RuchchaSD/Portenta_h7_breakout/README.md

# Portenta_h7_breakout
This  library contains the design files and design procedure of the breakout board portenta playmate
