RuchchaSD/Portenta_h7_breakout/lasercut parts/Bottom.DXF

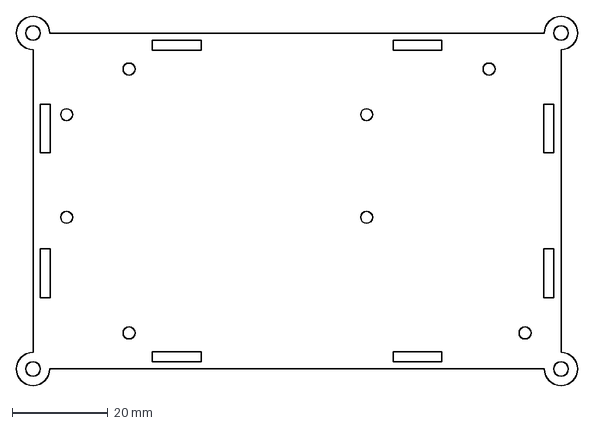
[picture p25: CAD file, 2023-09-10]
lasercut parts/Bottom.DXF
117.0 x 77.0 mm
