RuchchaSD/Portenta_h7_breakout/lasercut parts/front.DXF

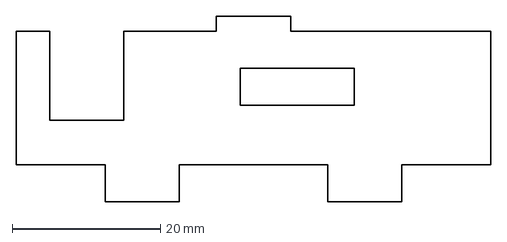
[picture p26: CAD file, 2023-09-10]
lasercut parts/front.DXF
64.0 x 25.0 mm
