RuchchaSD/Portenta_h7_breakout/lasercut parts/right.DXF

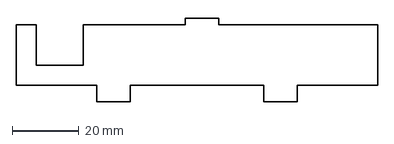
[picture p27: CAD file, 2023-09-10]
lasercut parts/right.DXF
108.0 x 25.0 mm
