RuchchaSD/Portenta_h7_breakout/lasercut parts/rear.DXF

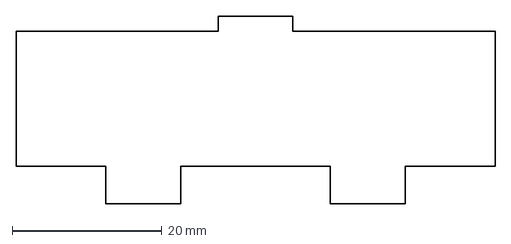
[picture p28: CAD file, 2023-09-10]
lasercut parts/rear.DXF
64.0 x 25.0 mm
