RuchchaSD/Portenta_h7_breakout/lasercut parts/Top.DXF

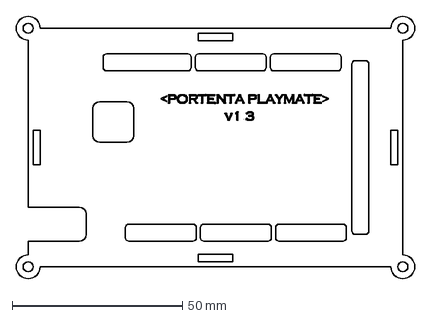
[picture p29: CAD file, 2023-09-10]
lasercut parts/Top.DXF
117.0 x 77.0 mm
