RuchchaSD/Portenta_h7_breakout/lasercut parts/left.DXF

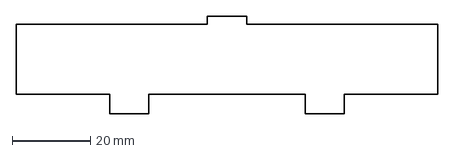
[picture p30: CAD file, 2023-09-10]
lasercut parts/left.DXF
108.0 x 25.0 mm
