RuchchaSD/Portenta_h7_breakout/Portanta Playmate schematic.pdf

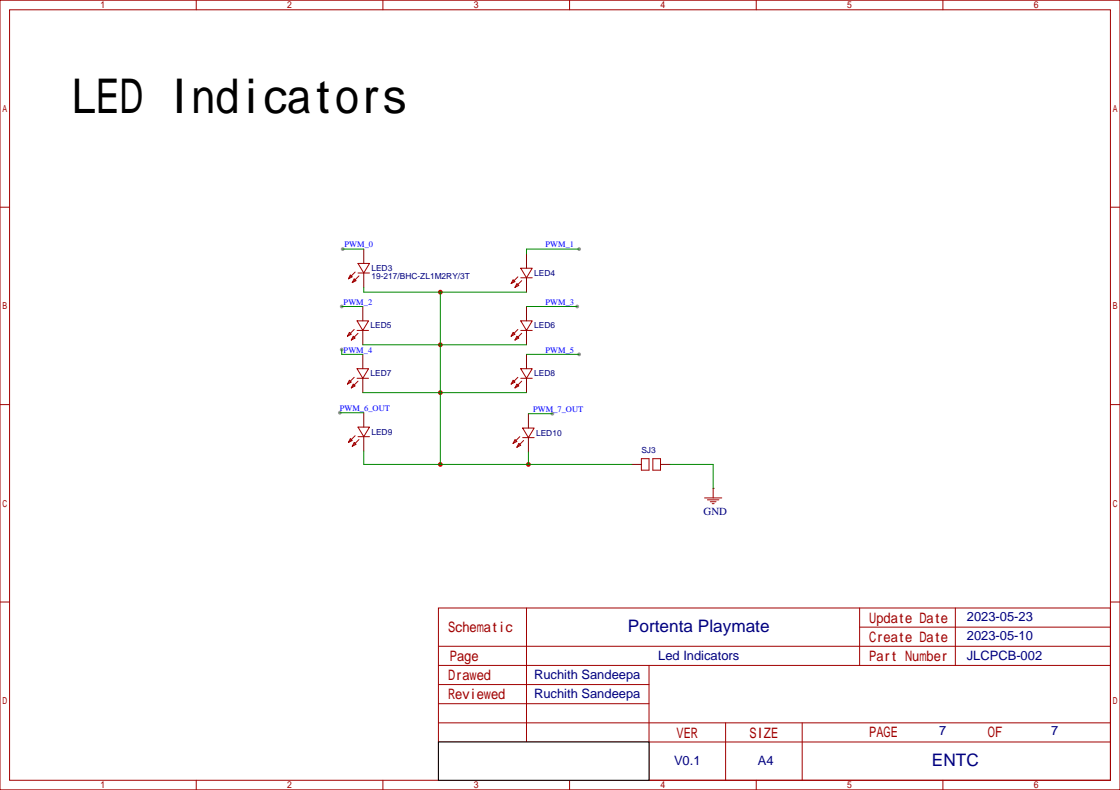
[picture p37: page 7]
