RuchchaSD/Portenta_h7_breakout/Portanta Playmate schematic.pdf

+5V

# Header Connections

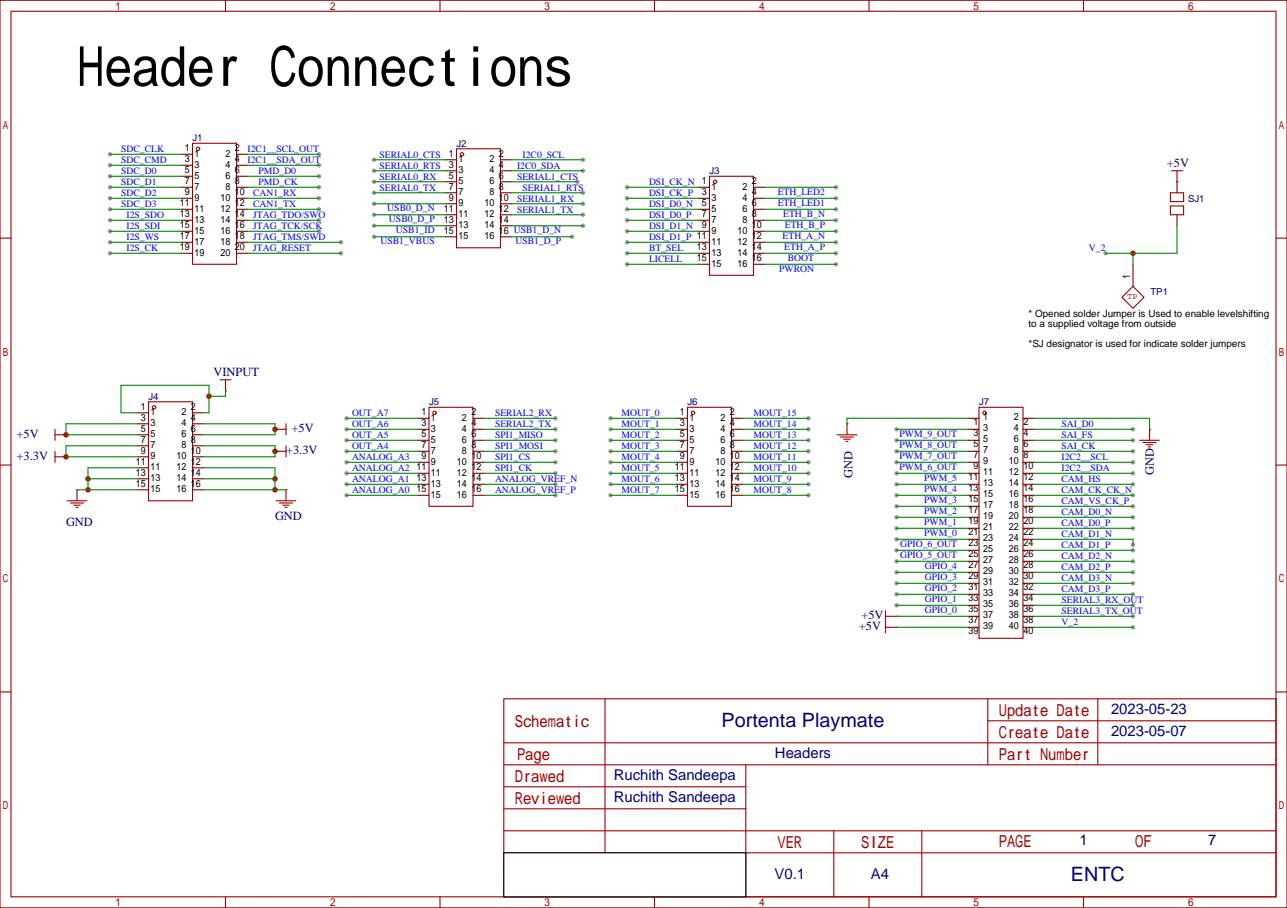
[picture p31: page 1]

* Opened solder Jumper is Used to enable levelshifting
to a supplied voltage from outside
*SJ designator is used for indicate solder jumpers

+5V

# Analog Multiplexer

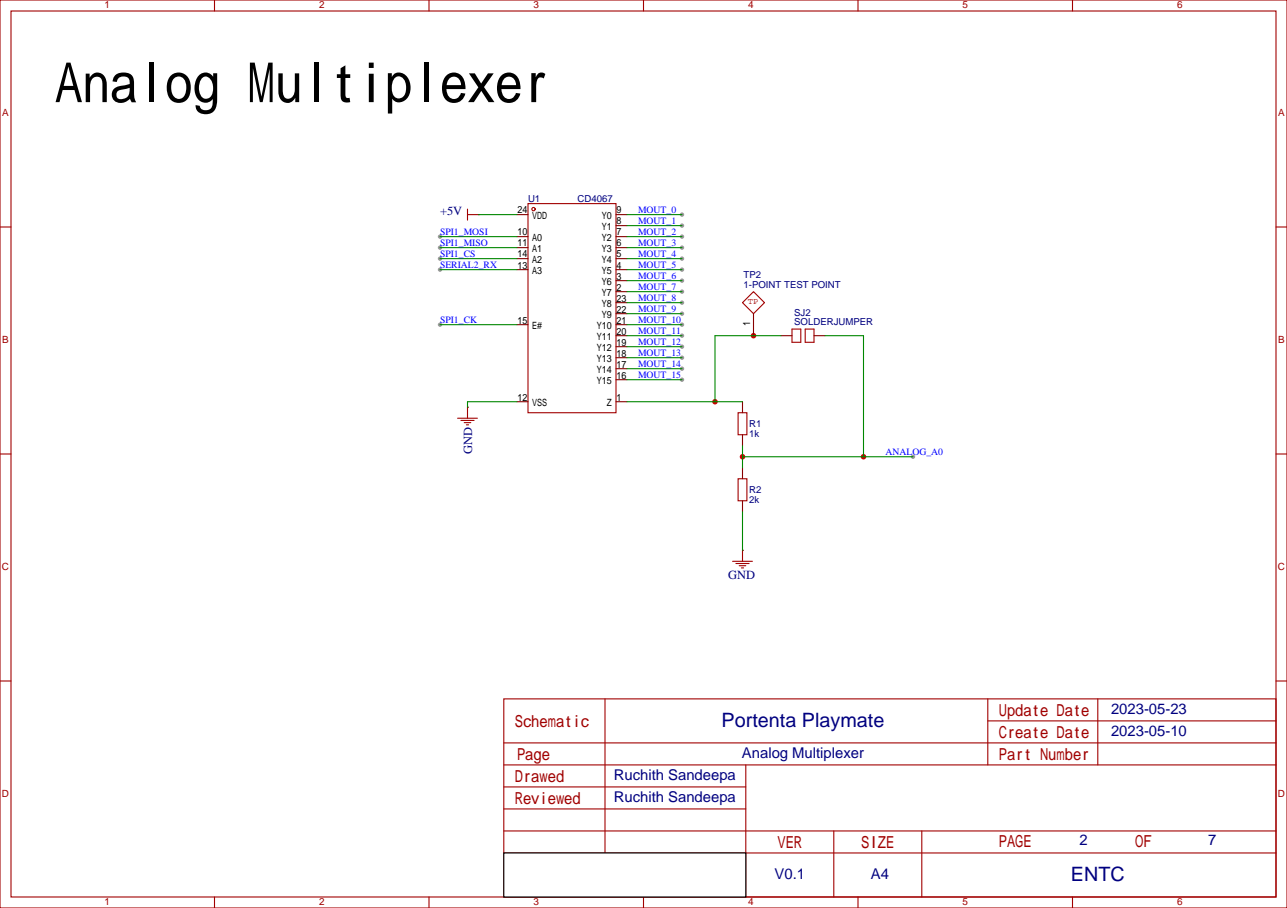
[picture p32: page 2]

+3.3V

### UPPER RIGHT BO

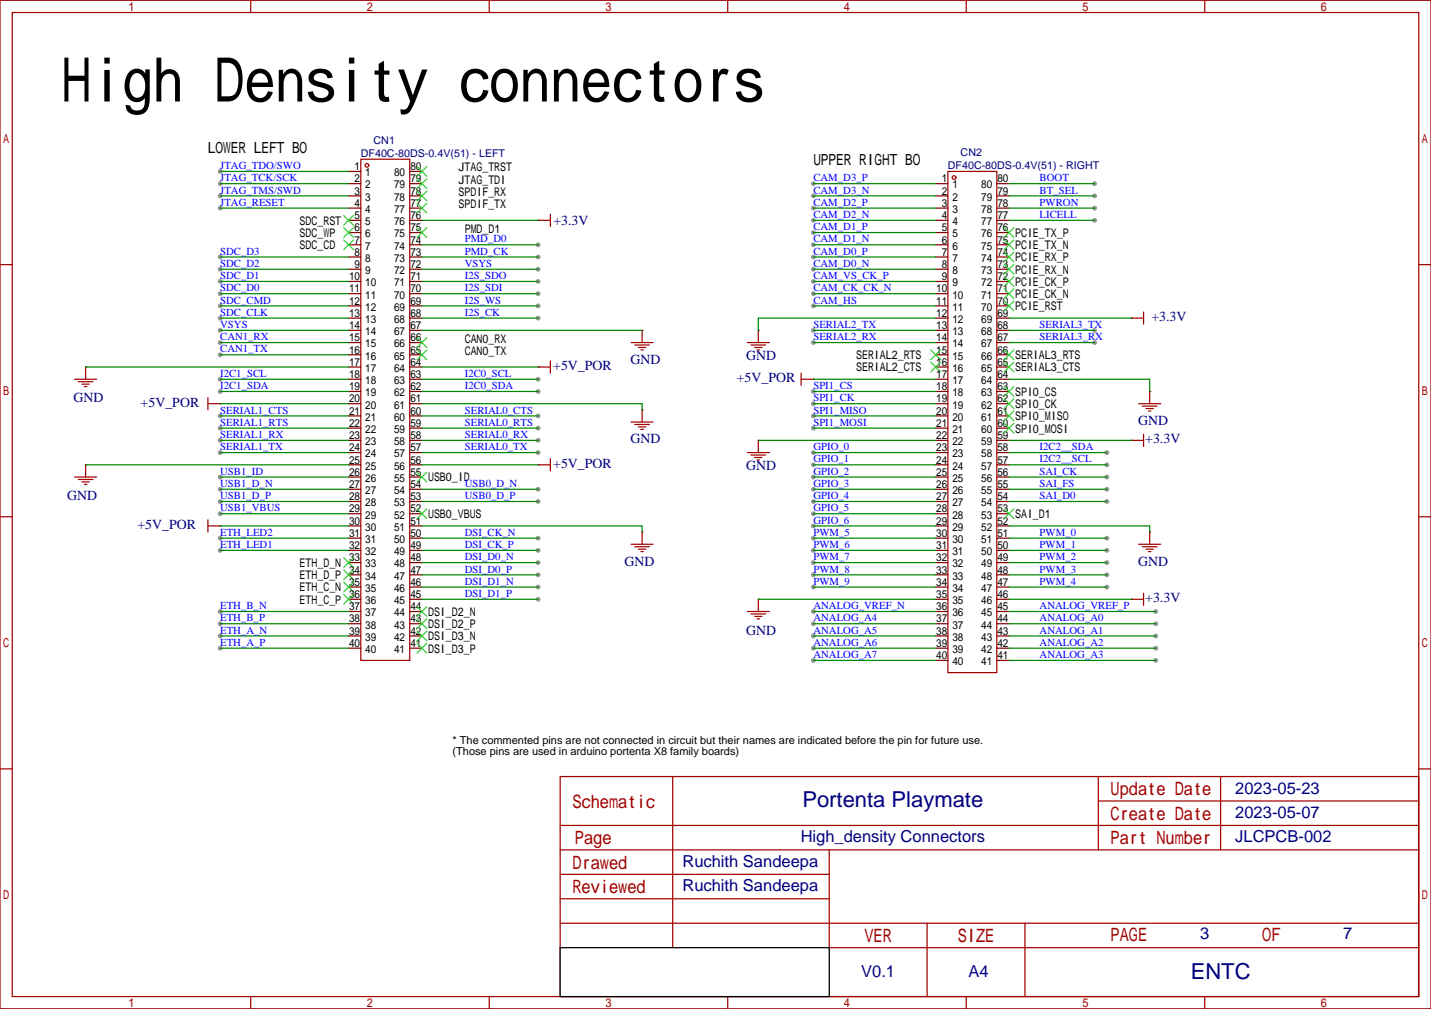
[picture p33: page 3]

* The commented pins are not connected in circuit but their names are indicated before the pin for future use.
(Those pins are used in arduino portenta X8 family boards)

# Power Circuit

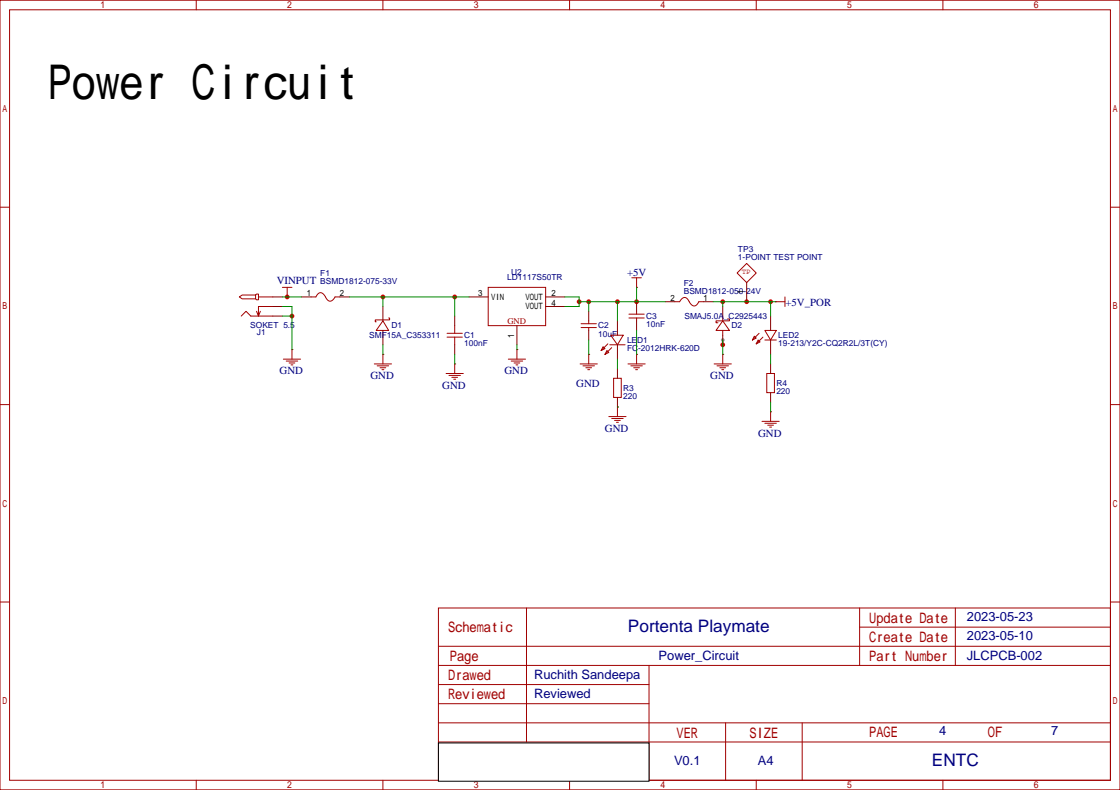
[picture p34: page 4]

# Current limited/ Short circuit/ Over voltage protected pins

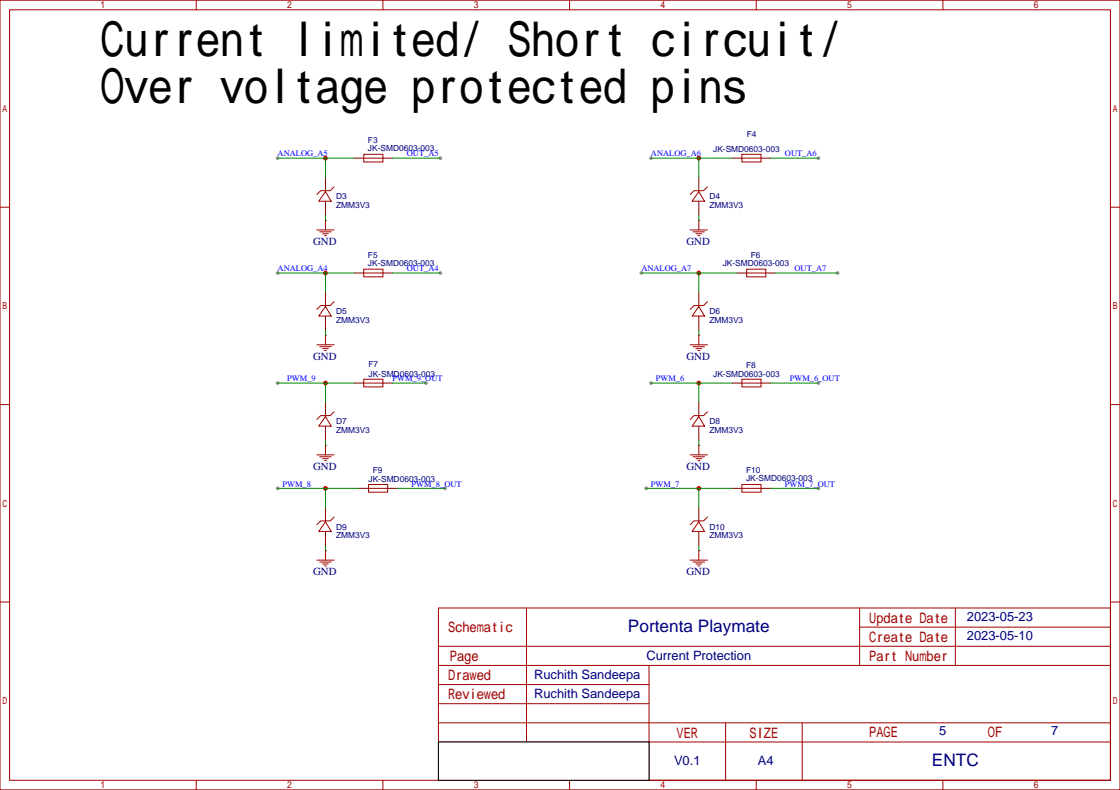
[picture p35: page 5]

+3.3V

+3.3V

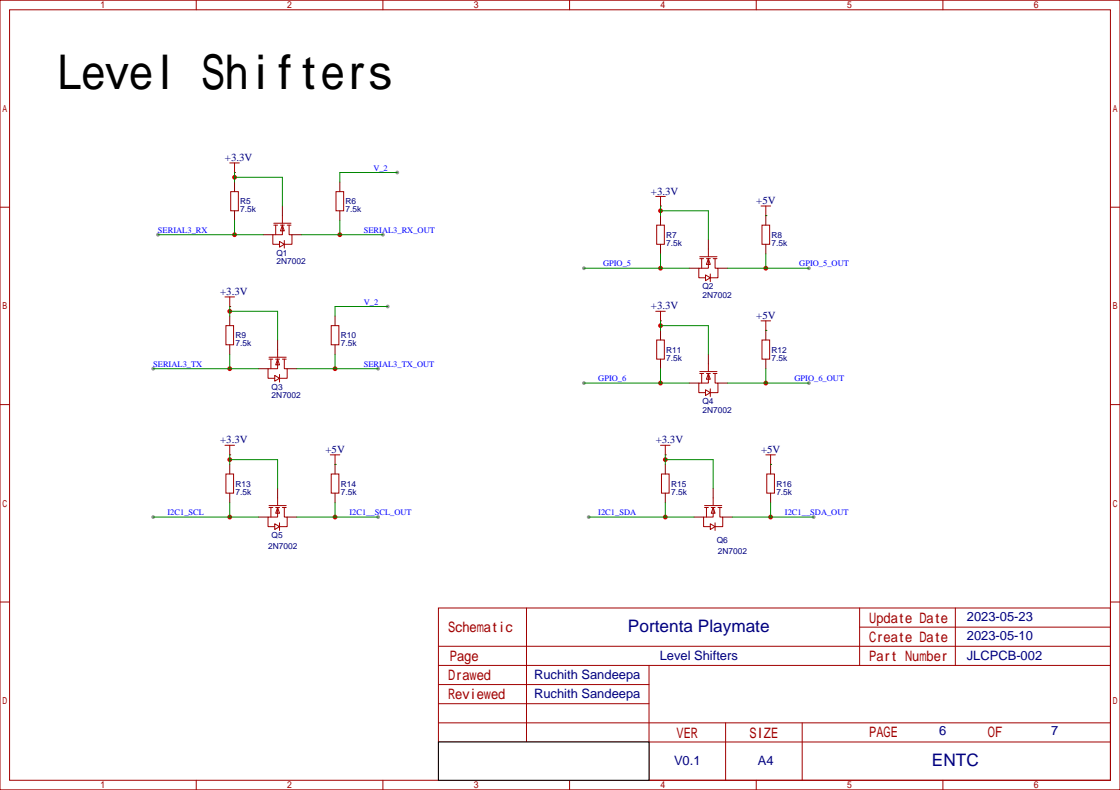
[picture p36: page 6]

# LED Indicators
